JakubKohoutek/water_leak_sensor/(list of files, drawings)

Other design files:
circuit_diagram/easyeda_source_code.json
