JakubKohoutek/water_leak_sensor/melody.cpp

#include "Arduino.h"
#include "melody.h"
#include "pithces.h"

void playMelody (int melody[], int length) {
  int tempo = 144;
  int notes = length / 2;
  // this calculates the duration of a whole note in ms (60s/tempo)*4 beats
  int wholenote = (60000 * 4) / tempo;
  int divider = 0, noteDuration = 0;

  // iterate over the notes of the melody:
  for (int thisNote = 0; thisNote < notes * 2; thisNote = thisNote + 2) {

    // calculates the duration of each note
    divider = melody[thisNote + 1];
    if (divider > 0) {
      // regular note, just proceed
      noteDuration = (wholenote) / divider;
    } else if (divider < 0) {
      // dotted notes are represented with negative durations!!
      noteDuration = (wholenote) / abs(divider);
      noteDuration *= 1.5; // increases the duration in half for dotted notes
    }

    // we only play the note for 90% of the duration, leaving 10% as a pause
    tone(BUZZER_PIN, melody[thisNote], noteDuration*0.9);

    // Wait for the specief duration before playing the next note.
    delay(noteDuration);
    
    // stop the waveform generation before the next note.
    noTone(BUZZER_PIN);
  }
}
