JakubKohoutek/water_leak_sensor/(commit log)

2020-04-14 Add WIP arduino code snippet
2020-04-23 Improve stability by lower maximum sleep time
    [water_leak_sensor.ino]
2020-04-25 Add circuit diagram and update README
    [easyeda_circuit_diagram_source.json]
2020-04-25 Move circuit diagram files to a common folder
    [easyeda_source_code.json]
2020-04-26 Add case 3d model
2020-04-27 Use Serial only in debug mode to save power
2020-04-27 Add pictures of the finished sensor
2021-03-27 Play tone when water leak is detected
    [melody.cpp, melody.h, pithces.h, water_leak_sensor.ino]
2021-03-27 Update 3D model to use 18650 battery instead of 9V
2021-03-27 Update readme and circuit diagram
    [easyeda_source_code.json]
2021-10-28 Increase voltage measurements, add location
2022-10-26 Improve voltage measurements
2026-04-17 Add MQTT with Home Assistant auto-discovery and upload scripts
    Publishes battery voltage and leak state to MQTT on every wake with HA
    auto-discovery, so the sensor appears in Home Assistant with no manual
    YAML. Adds scripts/upload.sh and scripts/monitor.sh for ESP-12E
    (esp8266:esp8266:generic) with per-session port caching. Switches
    credentials to the shared <credentials.h> library and updates the
    README and CLAUDE.md accordingly.
    [mqtt.cpp, mqtt.h, water_leak_sensor.ino]
2026-04-17 Stabilise battery reading and show decimals in Home Assistant
    Sample ADC with the radio off and reject outliers with a trimmed mean
    (100 samples, drop top + bottom 10), plus a 16-sample warm-up — the
    old 100-sample unsorted average was visibly noisy in the logs. On the
    alarm path, move readVoltage() before connectToWiFi() so RF TX does
    not drop VCC during sampling. Publish suggested_display_precision=2
    in the battery discovery so Home Assistant shows 3.72 V instead of
    rounding.
    [mqtt.cpp, water_leak_sensor.ino]
2026-04-17 Use full suggested_display_precision key in MQTT discovery
    The abbreviated form sug_dsp_prc is documented as valid but HA honors
    it inconsistently in practice, so Home Assistant was still showing the
    battery voltage as an integer. The full key name works reliably.
2026-04-21 Report MQTT more often in case of leakage
    [water_leak_sensor.ino]
